a-nguyen28/ecg_shield/Assembly/ECG Monitor BOM.xlsx

Designator | Value | LCSC Part Number | Quantity | Manufacturer | MPN | Assemble
U1 |  | C1519519 | 1 | ADI | AD8232ACPZ-WP | Yes
C1 | 1nF | C307441 | 1 | Samsung Electro-Mechanics | CL05C102JB5NNNC | Yes
C2, C3 | .33μF | C18164591 | 2 | CCTC | TCC0402X7R334K100AT | Yes
C4, C5 | .1μF | C60474 | 2 | YAGEO | CC0402KRX7R7BB104 | Yes
C6 | 10nF | C15195 | 1 | Samsung Electro-Mechanics | CL05B103KB5NNNC | Yes
C7 | 1.5nF | C281752 | 1 | YAGEO | CC0402JRX7R9BB152 | Yes
R1, R2, R6, R8, R9, R10 | 10MΩ | C2933065 | 6 | FOJAN | FRC0402F1005TS | Yes
R3, R4 | 180kΩ | C138046 | 2 | YAGEO | RC0402FR-07180KL | Yes
R5 | 360kΩ | C163471 | 1 | YAGEO | RC0402FR-07360KL | Yes
R7 | 1.4MΩ | C477213 | 1 | YAGEO | RC0402FR-071M4L | Yes
R11 | 100kΩ | C60491 | 1 | YAGEO | RC0402FR-07100KL | Yes
R12, R13, R14 | 1MΩ | C138033 | 3 | YAGEO | RC0402FR-071ML | Yes
J1 |  |  | 1 |  |  | No
J2 |  |  | 1 |  |  | No
J3, J4 |  |  | 2 |  |  | No
J5 |  |  | 1 |  |  | No
