a-nguyen28/ecg_shield/(list of files, drawings)

Other design files:
Altium/ECG Monitor.PrjPcb
Altium/PCB2.PcbDoc
Altium/Sheet1.SchDoc
