a-nguyen28/ecg_shield/(commit log)

2026-09-28 Initial file upload
    [ECG Monitor.PrjPcb, PCB2.PcbDoc, Sheet1.SchDoc]
2026-10-02 Add project details for ECG Arduino Shield
